therealmiguel/Diplomarbeit/README.md

# Diplomarbeit
AQS – Autonomous Quadcopter System: GPSunabhängige autonome Navigation eines Quadcopters mittels visueller Tiefenerkennung und Künstlicher Intelligenz
