therealmiguel/Diplomarbeit/3D/render.png

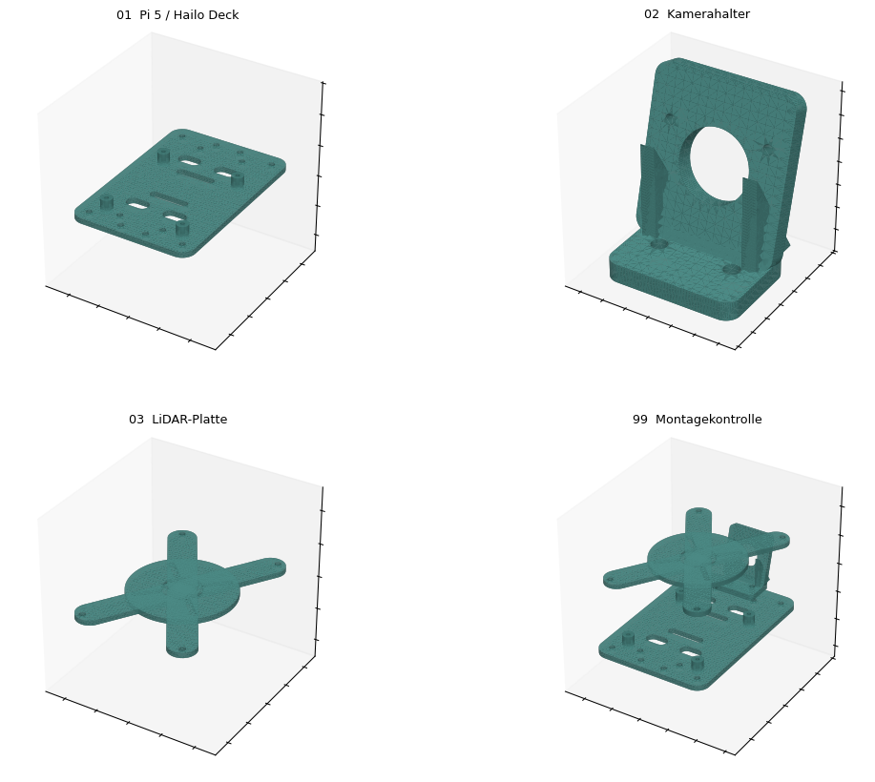
3D/render.png
