therealmiguel/Diplomarbeit/3D/99_assembly_check.stl

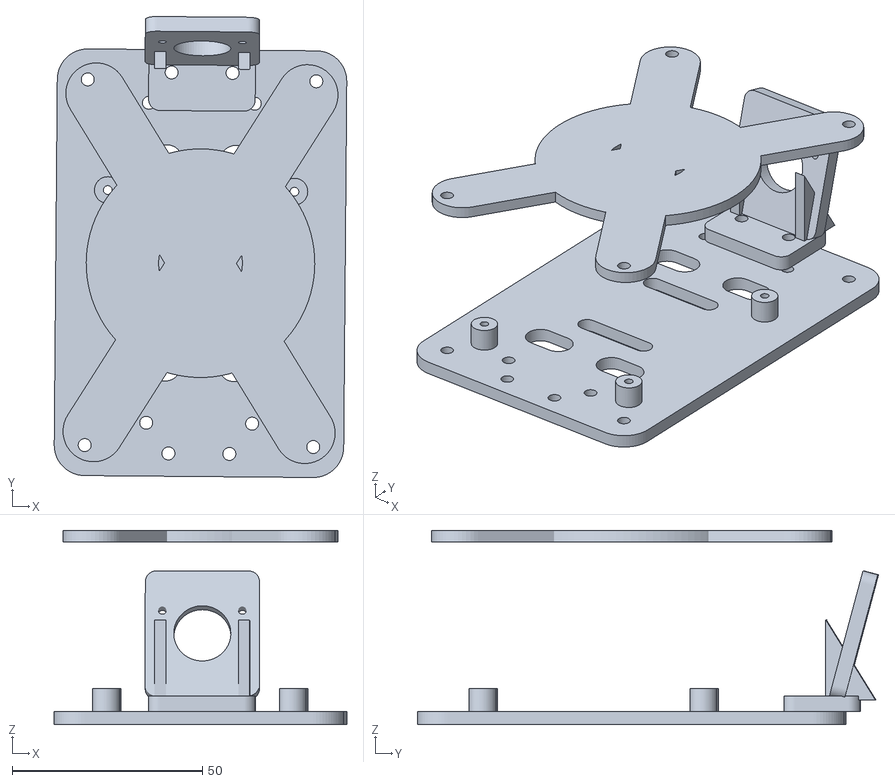
[picture p2: CAD file, 2026-10-07]
3D/99_assembly_check.stl
76.8 x 121.0 x 51.0
