therealmiguel/Diplomarbeit/3D/04_stuetzen_35mm.stl

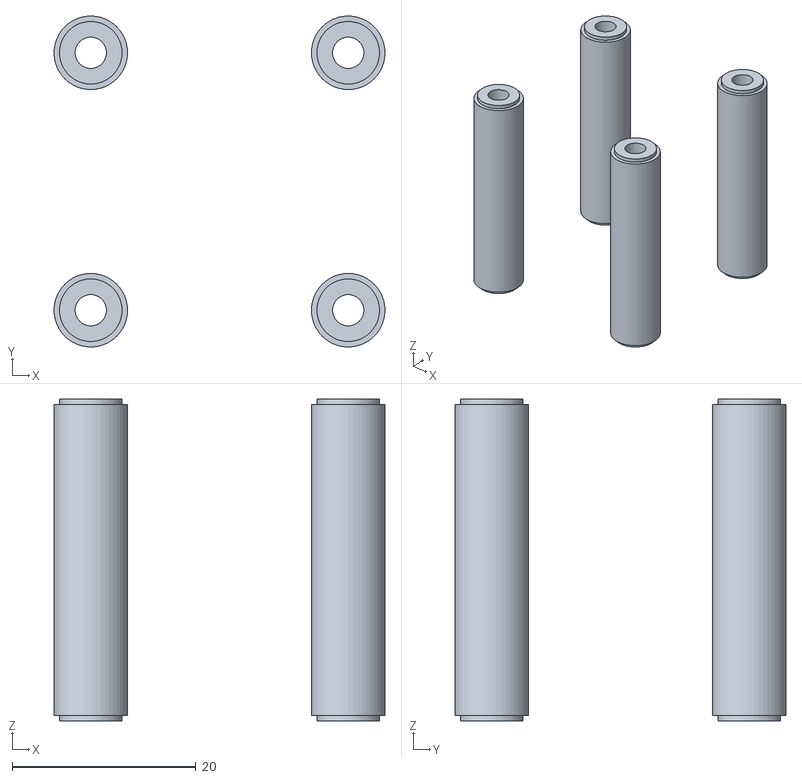
[picture p3: CAD file, 2026-10-07]
3D/04_stuetzen_35mm.stl
36.0 x 36.0 x 35.0
