therealmiguel/Diplomarbeit/3D/LX7+Drone+Frame_stls/obj_12_Standoff.step.stl

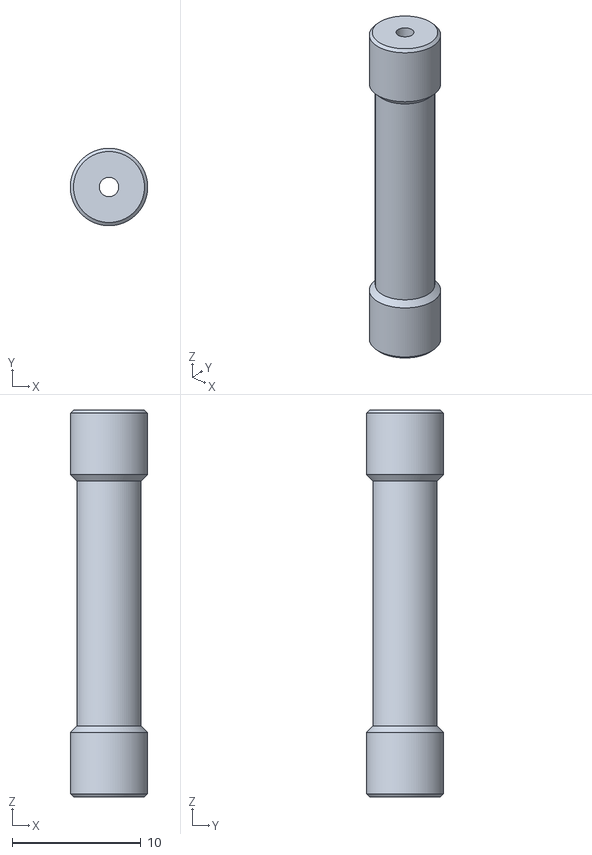
[picture p4: CAD file, 2026-10-07]
3D/LX7+Drone+Frame_stls/obj_12_Standoff.step.stl
6.00 x 6.00 x 30.0
