therealmiguel/Diplomarbeit/3D/03_lidar_plate.stl

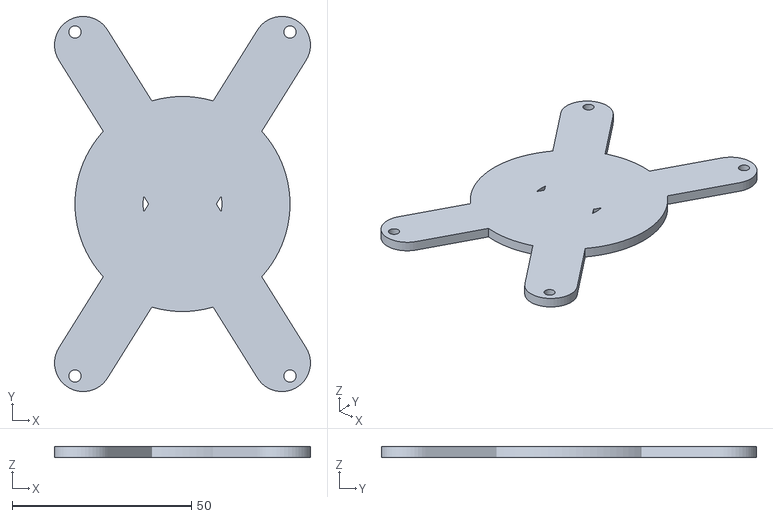
[picture p5: CAD file, 2026-10-07]
3D/03_lidar_plate.stl
71.4 x 104.7 x 3.00
