therealmiguel/Diplomarbeit/3D/LX7+Drone+Frame_stls/obj_17_Bottom Plate.step.stl

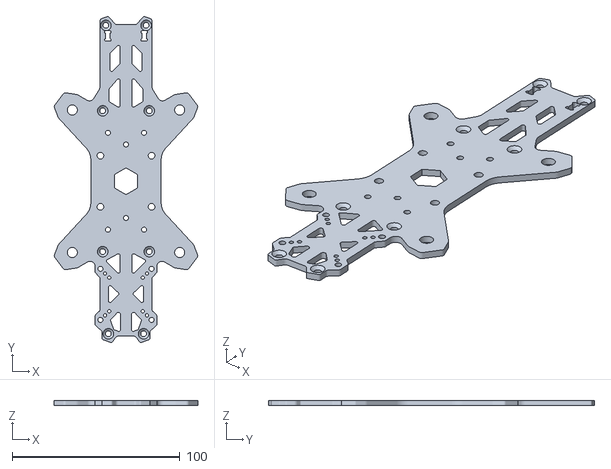
[picture p6: CAD file, 2026-10-07]
3D/LX7+Drone+Frame_stls/obj_17_Bottom Plate.step.stl
85.6 x 194.5 x 3.00
