therealmiguel/Diplomarbeit/3D/01_pi_deck.stl

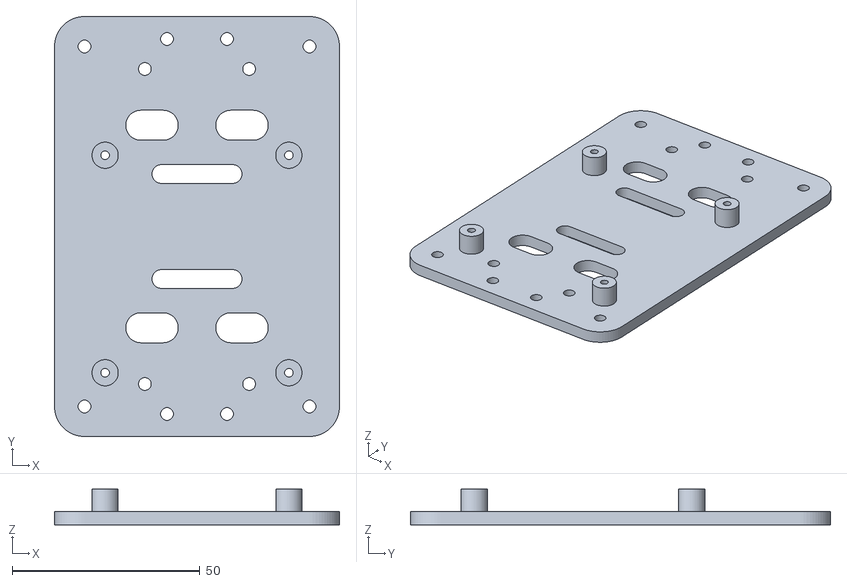
[picture p7: CAD file, 2026-10-07]
3D/01_pi_deck.stl
76.0 x 112.0 x 9.50
