therealmiguel/Diplomarbeit/3D/04_stuetzen_25mm.stl

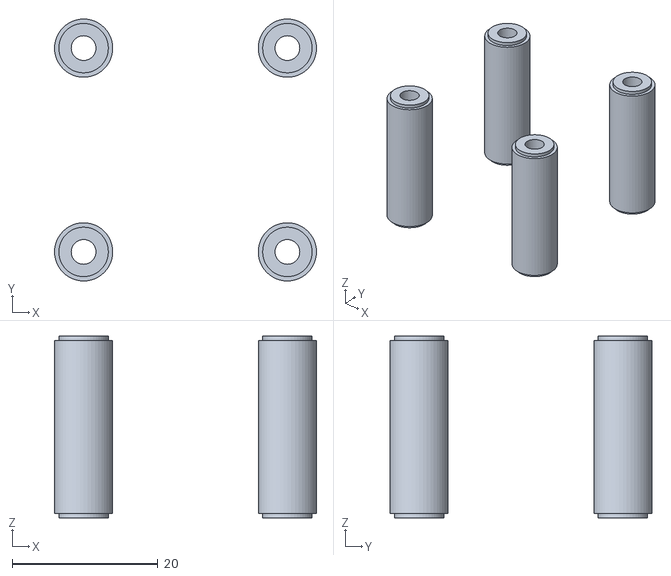
[picture p8: CAD file, 2026-10-07]
3D/04_stuetzen_25mm.stl
36.0 x 36.0 x 25.0
