therealmiguel/Diplomarbeit/3D/LX7+Drone+Frame_stls/obj_4_Arm.step.stl

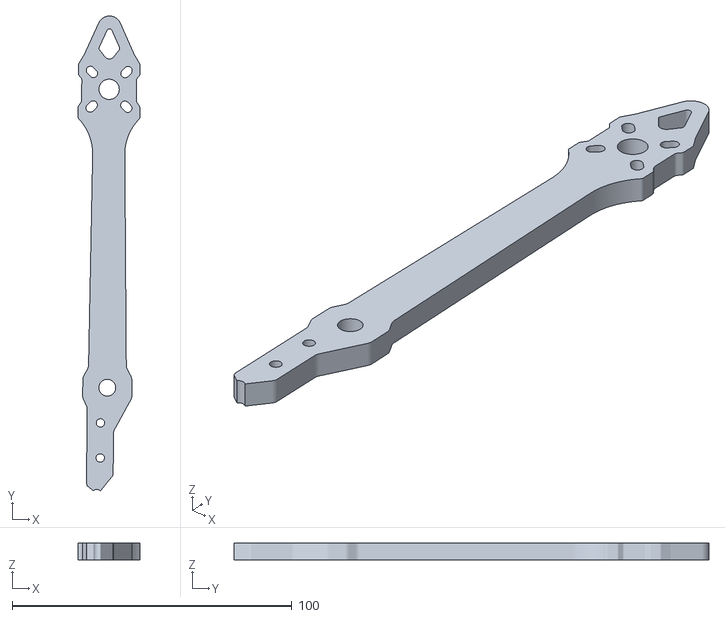
[picture p9: CAD file, 2026-10-07]
3D/LX7+Drone+Frame_stls/obj_4_Arm.step.stl
22.2 x 169.9 x 6.00
