therealmiguel/Diplomarbeit/3D/04_stuetzen_40mm.stl

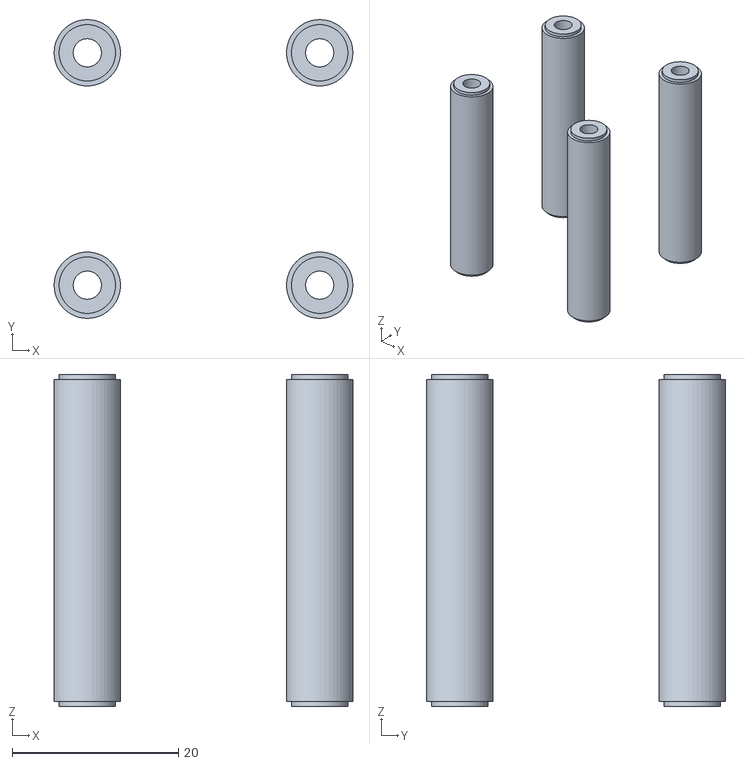
[picture p10: CAD file, 2026-10-07]
3D/04_stuetzen_40mm.stl
36.0 x 36.0 x 40.0
