therealmiguel/Diplomarbeit/3D/LX7+Drone+Frame_stls/obj_2_Arm Plate.step.stl

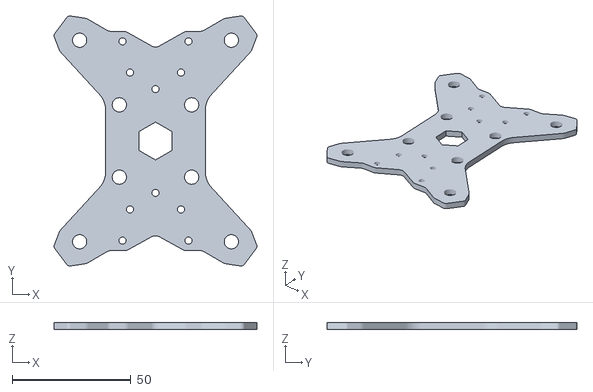
[picture p11: CAD file, 2026-10-07]
3D/LX7+Drone+Frame_stls/obj_2_Arm Plate.step.stl
85.6 x 105.5 x 3.00
