therealmiguel/Diplomarbeit/3D/04_stuetzen_30mm.stl

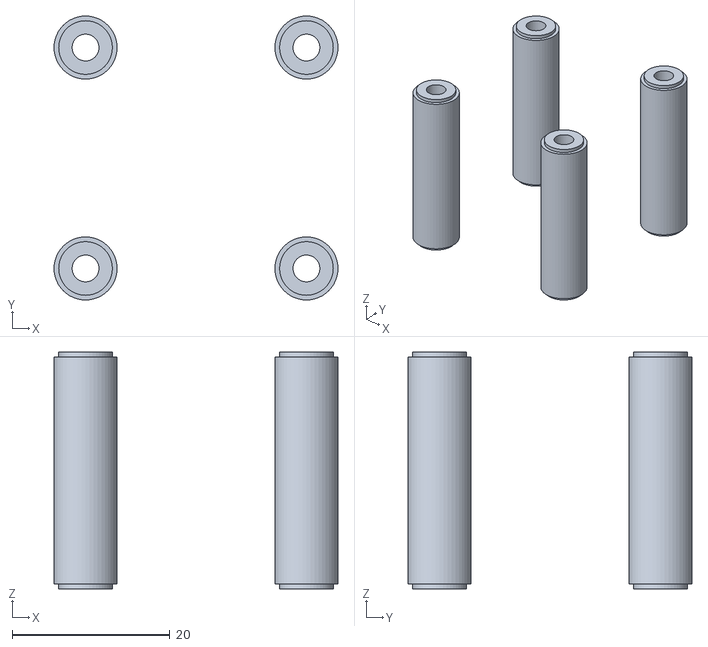
[picture p12: CAD file, 2026-10-07]
3D/04_stuetzen_30mm.stl
36.0 x 36.0 x 30.0
