therealmiguel/Diplomarbeit/3D/02_camera_mount.stl

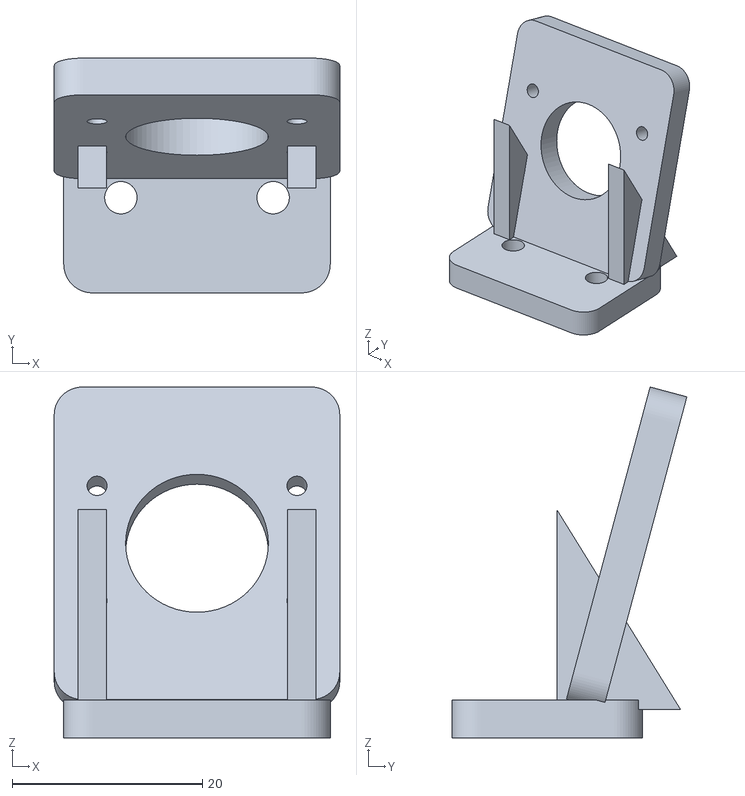
[picture p13: CAD file, 2026-10-07]
3D/02_camera_mount.stl
30.0 x 24.7 x 36.9
