therealmiguel/Diplomarbeit/3D/LX7+Drone+Frame_stls/obj_3_Top Plate.step.stl

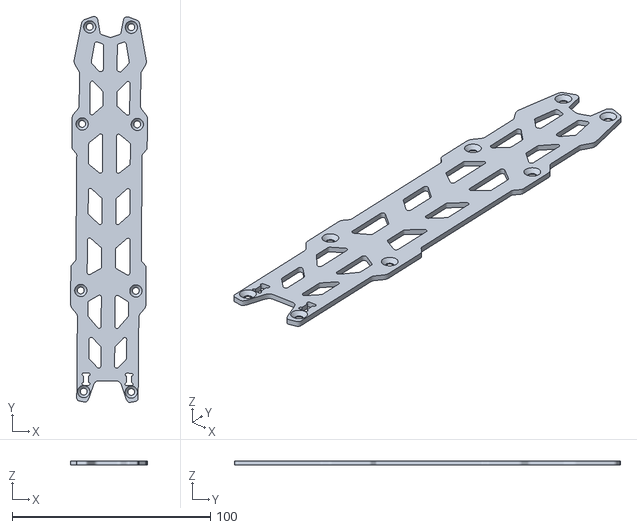
[picture p14: CAD file, 2026-10-07]
3D/LX7+Drone+Frame_stls/obj_3_Top Plate.step.stl
38.8 x 194.7 x 2.00
