therealmiguel/Diplomarbeit/3D/LX7+Drone+Frame_stls/obj_8_Armstop001.step.stl

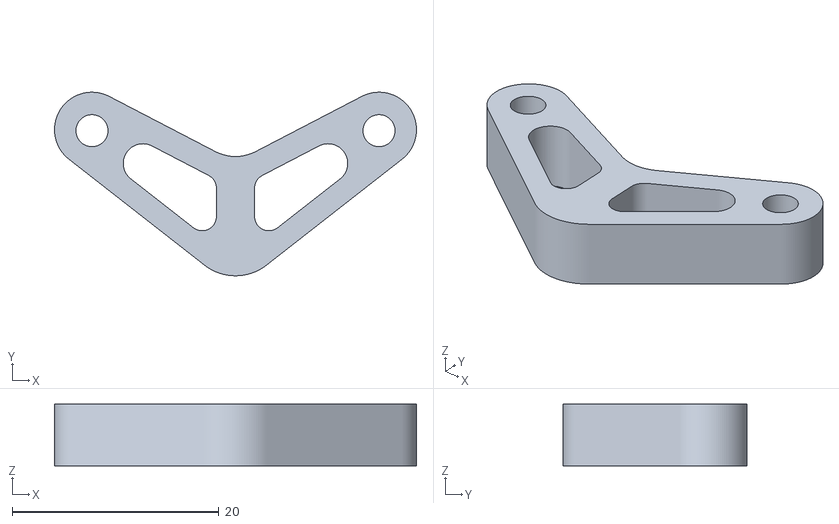
[picture p15: CAD file, 2026-10-07]
3D/LX7+Drone+Frame_stls/obj_8_Armstop001.step.stl
35.1 x 17.8 x 6.00
