therealmiguel/Diplomarbeit/(list of files, cad)

Other CAD files:
3D/LX7+Drone+Frame_stls/obj_16_Standoff.step.stl
3D/LX7+Drone+Frame_stls/obj_10_Standoff.step.stl
3D/LX7+Drone+Frame_stls/obj_7_Arm001.step.stl
3D/LX7+Drone+Frame_stls/obj_13_Standoff.step.stl
3D/LX7+Drone+Frame_stls/obj_11_Standoff.step.stl
3D/LX7+Drone+Frame_stls/obj_6_Arm002.step.stl
3D/LX7+Drone+Frame_stls/obj_5_Arm003.step.stl
3D/LX7+Drone+Frame_stls/obj_1_Standoff.step.stl
3D/LX7+Drone+Frame_stls/obj_15_Standoff.step.stl
3D/LX7+Drone+Frame_stls/obj_14_Standoff.step.stl
3D/LX7+Drone+Frame_stls/obj_9_Armstop.step.stl
