therealmiguel/Diplomarbeit/Raspberry Pi vulture – Setup-Dokumentation.docx

# Raspberry Pi vulture – Setup-Dokumentation

Nov 12, 2026 · @N D

## Überblick

Der Pi vulture steuert den Diplomarbeits-Quadcopter per MAVLink. Hailo-Erkennung, Simulator-Flug und Lidar-Auslesen funktionieren. Die echte Verbindung zum Flight Controller ist noch nicht getestet.

### Hardware

Teil | Modell | Anschluss am Pi
Rechner | Raspberry Pi 5, 8 GB, Hostname vulture | –
KI-Beschleuniger | Hailo AI HAT+ (Hailo-8L, 13 TOPS) | PCIe
Kamera | Raspberry Pi Camera Module 3 (imx708) | CSI-Flachbandkabel
Lidar | WitMotion D6 TOF (Sensor COIN-D6), 360°, 0,05–12 m | USB über CH341-Adapter, /dev/ttyUSB0, 230400 Baud
Flight Controller | SpeedyBee F405 V5 mit ArduCopter | UART (/dev/ttyAMA0, 921600 Baud), geplant
Empfänger | RadioMaster RP1 V2 (ELRS) | am FC, nicht am Pi
Optical Flow | Matek 3901-L0X | am FC, noch nicht angeschlossen
Akku | 4S LiPo 3300 mAh | über UBEC an die GPIO-Pins

### Die zwei Pis

Hostname | Pi | Strom | Zweck
vulture | Pi 5, 8 GB | Nur über GPIO-Pins (UBEC + Akku). Der USB-C-Eingang ist defekt. | Flug-Pi, später ROS2/SLAM
kit | Pi 5, 2 GB, eigener Hailo-HAT und Kamera | normal über USB-C | Altes Diplomarbeits-System (YOLOv8-Demo), jetzt Einrichtungs-Pi

### Ablauf mit der SD-Karte

1. Die SD-Karte von vulture steckt im 2-GB-Pi. Der startet dann als vulture mit allem, was installiert ist.
2. Dort richtest du alles ein, was wenig RAM braucht: Python-Code, Hailo-Tests, Lidar, pip-Pakete.
3. Danach die Karte zurück in den 8-GB-Pi.
4. Auf dem 8-GB-Pi: ROS2, SLAM, Docker-Builds und PSU_MAX_CURRENT (steht im EEPROM des Boards, nicht auf der Karte).

Bricht etwas auf dem 2-GB-Pi mit „Killed“ ab, war fast immer der RAM zu knapp. Das gehört dann auf den 8-GB-Pi.

### Sicherheitsregeln

- Nie UBEC und USB-C gleichzeitig anstecken.
- UBEC über einen Stecker anschließen, nicht direkt anlöten, und alles mit Schrumpfschlauch isolieren.
- Propeller ab, solange der Pi am FC hängt oder getestet wird.
- Nur einen Pi gleichzeitig einschalten, sonst kommen sich die Namen in die Quere.

## Verbinden vom Laptop (Windows-Eingabeaufforderung)

Alles läuft per SSH aus der Windows-CMD. Laptop und Pi müssen im selben WLAN sein.

### 1. Per SSH einloggen

Pi einschalten, 30–60 Sekunden warten, dann in der CMD:

ssh vulture@vulture.local

Klappt das nicht, ist vielleicht der andere Pi an:

ssh kit@kit.local

Wird .local nicht aufgelöst, die IP im Router unter „Angeschlossene Geräte“ nachsehen und ssh vulture@<IP> nehmen.

### 2. Prüfen, welcher Pi es ist

hostname
free -h | head -2
ls ~
hostname -I

Ausgabe | Bedeutung
vulture, ca. 8 GB, Ordner hailo-apps und vulture-flight | 8-GB-Pi mit der Flug-Karte
vulture, ca. 2 GB | Flug-Karte im 2-GB-Pi
kit | alte Karte, alter Pi

hostname -I zeigt die IP. Die brauchst du für den Simulator (zuletzt war es 192.168.1.37).

### 3. Desktop per VNC

Einmalig am Pi einschalten:

sudo raspi-config

→ 3 Interface Options → VNC → Yes → Finish. Dabei wird der Dienst wayvnc angelegt.

Am Laptop TigerVNC Viewer öffnen, Adresse vulture.local:5900, Benutzer vulture und dein Pi-Passwort. Die Zertifikatswarnung kannst du bestätigen.

Verbindet es nicht:

systemctl status wayvnc --no-pager | head -5
sudo systemctl restart wayvnc

### 4. Code auf den Laptop sichern

In einer eigenen CMD am Laptop (nicht im SSH-Fenster):

scp -r vulture@vulture.local:~/vulture-flight .

Das kopiert den ganzen Ordner vulture-flight in den aktuellen Ordner der CMD.

### 5. Alles sauber abdrehen

1. Laufende Programme mit Strg+C beenden, VNC-Fenster schließen.
2. Pi herunterfahren:

sudo shutdown now

3. Warten, bis die grüne LED nicht mehr blinkt (10–20 Sekunden). Erst dann den Strom abstecken.
4. Lidar-USB-Adapter abziehen, Akku abstecken. In Mission Planner Disconnect, dann USB vom FC.
5. Akku auf eine nicht brennbare Unterlage oder in die LiPo-Tasche. Fliegst du ein paar Tage nicht, mit Storage am iMars auf ca. 3,8 V pro Zelle laden.

## Grundsystem und Hailo

Die Hailo-Seite ist fertig: Treiber, Modelle für hailo8l und die Live-Erkennung mit der Kamera laufen.

### Was installiert ist (Stand 26./27. August)

Komponente | Stand
Betriebssystem | Raspberry Pi OS 64-bit, headless mit SSH, Kernel 6.18
PCIe | Gen3 aktiv: dtparam=pciex1_gen=3 in /boot/firmware/config.txt
Hailo-Pakete | hailo-all 5.1.1 per apt (Treiber, Firmware, HailoRT, TAPPAS 5.1.0, rpicam-Hailo-Postprocess)
hailo-rpi5-examples | ließ sich nicht kompilieren, gelöscht
~/hailo-apps | installiert, venv venv_hailo_apps, 20 Modelle (.hef) unter /usr/local/hailo/resources, 15 C++-Postprocess-Libs
Werkzeuge | tmux
Python-Pakete | pymavlink 2.4.50, pyserial

### Hailo-Umgebung aktivieren

cd ~/hailo-apps && source setup_env.sh

Danach steht (venv_hailo_apps) vor dem Prompt.

### Zustand prüfen

hostname
free -h | head -2
hailortcli fw-control identify
rpicam-hello --list-cameras
vcgencmd get_throttled
grep -E "pciex1|uart|usb_max" /boot/firmware/config.txt
ls ~

Befehl | Erwartet
hailortcli fw-control identify | Device Architecture: HAILO8L („Board Name: Hailo-8“ ist normal)
rpicam-hello --list-cameras | 0 : imx708 [4608x2592 10-bit RGGB]
vcgencmd get_throttled | throttled=0x0 = keine Unterspannung

### Architektur der Modelle prüfen

Der Installer meldete damals „hailo8“. Geprüft ist: Die Konfiguration stimmt.

cat /usr/local/hailo/resources/.env
ls /usr/local/hailo/resources/models/

In der .env muss hailo_arch=hailo8l stehen. Bei dir steht außerdem: hailort_version=4.23.0, tappas_version=5.1.0, model_zoo_version=v2.17.0.

### Live-Erkennung mit Kamera und Hailo

Im Terminal auf dem VNC-Desktop (nicht per SSH, weil ein Fenster aufgeht):

rpicam-hello -t 0 --post-process-file /usr/share/rpi-camera-assets/hailo_yolov8_inference.json --lores-width 640 --lores-height 640

Es öffnet sich das Kamerabild mit Rahmen um erkannte Objekte. Beenden mit Strg+C. Das hat funktioniert.

### Hailo-Apps für vision.py ansehen

cd ~/hailo-apps && source setup_env.sh
ls hailo_apps/hailo_app_python/apps/
ls hailo_apps/hailo_app_python/apps/detection
grep -n "callback\|get_roi_from_buffer\|get_objects_typed\|get_label\|get_bbox" -r hailo_apps/hailo_app_python/apps/detection | head -30

Die Ausgabe davon fehlt noch. Erst damit lässt sich vision.py passend zur Repo-Version schreiben.

## UART und MAVLink zum SpeedyBee F405

Am Pi ist der UART freigeschaltet, und der FC armt per Fernsteuerung. Das Kabel Pi ↔ FC und der Test am echten FC fehlen noch.

### 1. UART am Pi aktivieren (erledigt)

sudo raspi-config

→ 3 Interface Options → Serial Port:

- „Login shell over serial?“ → No
- „Serial port hardware enabled?“ → Yes

Dann:

echo "dtparam=uart0=on" | sudo tee -a /boot/firmware/config.txt
mkdir -p ~/vulture-flight
source ~/hailo-apps/setup_env.sh
pip install pymavlink pyserial
sudo reboot

Nach dem Neustart prüfen:

ls -l /dev/ttyAMA0
grep -E "enable_uart|uart0" /boot/firmware/config.txt

In deiner config.txt steht dtparam=uart0=on zweimal. Das schadet nicht, eine Zeile kannst du mit sudo nano /boot/firmware/config.txt löschen.

### 2. Verkabelung Pi ↔ FC (noch offen)

TX und RX werden gekreuzt, 5 V wird nicht verbunden. Beide Seiten arbeiten mit 3,3 V.

Pi 5 | SpeedyBee F405 V5 (UART4)
Pin 8 (GPIO14, TX) | RX4
Pin 10 (GPIO15, RX) | TX4
Pin 6 (GND) | GND

### 3. ArduPilot-Parameter

In Mission Planner unter Config → Full Parameter List, schreiben und FC neu starten.

Parameter | Wert | Bedeutung | Stand
SERIAL2_PROTOCOL | 23 | RC-Eingang für den RP1 auf UART2 | gesetzt
SERIAL6_PROTOCOL | -1 | UART6 aus | gesetzt
MOT_PWM_TYPE | 6 | DShot600. Bei 0 haben die Motoren nicht reagiert. | gesetzt
COMPASS_ENABLE | 0 | Kein Kompass auf dem Board, GPS geht indoor nicht | gesetzt
SERIAL4_PROTOCOL | 2 | MAVLink2 zum Pi auf UART4 | geplant
SERIAL4_BAUD | 921 | 921600 Baud | geplant

Die Motoren armen und reagieren mit der RadioMaster im Mode 2: links Gas und Gier, rechts Nick und Roll.

### 4. Auf echten FC umstellen

In ~/vulture-flight/config.py SIM = False setzen:

sed -i 's/^SIM = .*/SIM = False/' ~/vulture-flight/config.py

Dann verbindet link.py über /dev/ttyAMA0 mit 921600 Baud statt mit dem Simulator. Erst mit Propellern ab testen.

## Flugcode im Simulator

Der Pi hat den virtuellen Copter in Mission Planner gestartet, bewegt (GroundSpeed über 1 m/s) und gelandet. Alle Dateien liegen in ~/vulture-flight.

### Simulator am Laptop starten

1. Mission Planner → oben Simulation → Multirotor → Stable, warten, bis der Copter auf der Karte steht.
2. Strg+F → MAVLink → UDP Client, IP = IP des Pi (hostname -I, zuletzt 192.168.1.37), Port 14550.
3. Erst dann die Skripte am Pi starten.

### Dateien im Ordner

Datei | Zweck
test_sim.py | erster Verbindungstest, liest 5-mal die Höhe
test_flug.py | GUIDED, armen, 2 m hoch, 5 s vorwärts, landen
config.py | Umschalter Simulator / echter FC
link.py | wiederverwendbares Modul für MAVLink
test_quadrat.py | fliegt mit link.py ein Quadrat
lidar_decode.py, lidar.py, test_lidar.py | Lidar, siehe nächster Abschnitt

Jeden Block komplett ins SSH-Fenster kopieren. Der cat > ... << 'EOF'-Befehl legt die Datei an, bis zur Zeile EOF.

### test_sim.py

cat > ~/vulture-flight/test_sim.py << 'EOF'
from pymavlink import mavutil

print("Warte auf den Simulator...")
m = mavutil.mavlink_connection('udpin:0.0.0.0:14550')
m.wait_heartbeat(timeout=30)
print(f"Verbunden mit System {m.target_system}")

for _ in range(5):
msg = m.recv_match(type='GLOBAL_POSITION_INT', blocking=True, timeout=5)
if msg:
print(f"Höhe: {msg.relative_alt/1000:.2f} m")
EOF

Starten: python ~/vulture-flight/test_sim.py. Ergebnis bei dir: Verbunden mit System 1, danach fünfmal Höhe: -0.01 m.

### test_flug.py

cat > ~/vulture-flight/test_flug.py << 'EOF'
import time
from pymavlink import mavutil

m = mavutil.mavlink_connection('udpin:0.0.0.0:14550')

# Auf den Copter warten (nicht auf Mission Planner selbst)
while True:
hb = m.recv_match(type='HEARTBEAT', blocking=True)
if hb.type != mavutil.mavlink.MAV_TYPE_GCS:
m.target_system = hb.get_srcSystem()
m.target_component = hb.get_srcComponent()
break
print("Verbunden mit dem Copter")

def hoehe():
msg = m.recv_match(type='GLOBAL_POSITION_INT', blocking=True, timeout=3)
return msg.relative_alt / 1000 if msg else 0.0

def fliege(vx, vy, dauer):
# vx = vorwärts, vy = rechts, in m/s
ende = time.time() + dauer
while time.time() < ende:
m.mav.set_position_target_local_ned_send(
0, m.target_system, m.target_component,
mavutil.mavlink.MAV_FRAME_BODY_OFFSET_NED,
0b0000111111000111,
0, 0, 0, vx, vy, 0, 0, 0, 0, 0, 0)
time.sleep(0.1)

# 1. GUIDED-Modus und Motoren an
m.set_mode('GUIDED')
time.sleep(1)
m.arducopter_arm()
m.motors_armed_wait()
print("Motoren an")

# 2. Abheben auf 2 m
m.mav.command_long_send(m.target_system, m.target_component,
mavutil.mavlink.MAV_CMD_NAV_TAKEOFF, 0, 0, 0, 0, 0, 0, 0, 2)
while True:
h = hoehe()
print(f"Höhe: {h:.2f} m")
if h > 1.9:
break

# 3. Vorwärts, dann stehen bleiben
print("Fliege vorwärts")
fliege(1.0, 0, 5)
print("Halte Position")
fliege(0, 0, 3)

# 4. Landen
print("Lande")
m.set_mode('LAND')
m.motors_disarmed_wait()
print("Gelandet, Motoren aus")
EOF

Starten: python ~/vulture-flight/test_flug.py.

### config.py

cat > ~/vulture-flight/config.py << 'EOF'
# True = Simulator am Laptop, False = echter F405 per UART
SIM = True

VERBINDUNG_SIM = 'udpin:0.0.0.0:14550'
VERBINDUNG_FC = '/dev/ttyAMA0'
BAUD_FC = 921600
EOF

### link.py

Läuft im Hintergrund mit und kennt immer Höhe, Lage, Modus und ob die Motoren an sind.

cat > ~/vulture-flight/link.py << 'EOF'
import time
import threading
from pymavlink import mavutil
import config

GCS = mavutil.mavlink.MAV_TYPE_GCS


class Link:
def __init__(self):
if config.SIM:
self.m = mavutil.mavlink_connection(config.VERBINDUNG_SIM)
else:
self.m = mavutil.mavlink_connection(config.VERBINDUNG_FC, baud=config.BAUD_FC)

# aktueller Zustand, wird im Hintergrund laufend aktualisiert
self.hoehe = 0.0
self.modus = ''
self.armed = False
self.roll = self.pitch = self.yaw = 0.0

self._warte_auf_copter()
self._laeuft = True
threading.Thread(target=self._empfangen, daemon=True).start()
time.sleep(1)

def _warte_auf_copter(self):
print('Warte auf Copter...')
while True:
hb = self.m.recv_match(type='HEARTBEAT', blocking=True)
if hb.type != GCS:
self.m.target_system = hb.get_srcSystem()
self.m.target_component = hb.get_srcComponent()
print(f'Verbunden mit System {self.m.target_system}')
return

def _empfangen(self):
while self._laeuft:
msg = self.m.recv_match(blocking=True, timeout=1)
if msg is None:
continue
typ = msg.get_type()
if typ == 'GLOBAL_POSITION_INT':
self.hoehe = msg.relative_alt / 1000
elif typ == 'ATTITUDE':
self.roll, self.pitch, self.yaw = msg.roll, msg.pitch, msg.yaw
elif typ == 'HEARTBEAT' and msg.type != GCS \
and msg.get_srcSystem() == self.m.target_system:
self.modus = mavutil.mode_string_v10(msg)
self.armed = bool(msg.base_mode & mavutil.mavlink.MAV_MODE_FLAG_SAFETY_ARMED)

def _warte_bis(self, bedingung, timeout):
ende = time.time() + timeout
while time.time() < ende:
if bedingung():
return True
time.sleep(0.1)
return False

def modus_setzen(self, name):
self.m.set_mode(name)
if self._warte_bis(lambda: self.modus == name, 5):
print(f'Modus: {name}')
return True
print(f'FEHLER: Moduswechsel auf {name} fehlgeschlagen')
return False

def armen(self):
self.m.arducopter_arm()
if self._warte_bis(lambda: self.armed, 10):
print('Motoren an')
return True
print('FEHLER: Armen fehlgeschlagen (Pre-Arm-Checks in Mission Planner ansehen)')
return False

def abheben(self, ziel_hoehe):
self.m.mav.command_long_send(
self.m.target_system, self.m.target_component,
mavutil.mavlink.MAV_CMD_NAV_TAKEOFF, 0, 0, 0, 0, 0, 0, 0, ziel_hoehe)
ende = time.time() + 20
while time.time() < ende:
print(f'Höhe: {self.hoehe:.2f} m')
if self.hoehe >= ziel_hoehe * 0.95:
print('Zielhöhe erreicht')
return True
time.sleep(0.5)
print('FEHLER: Zielhöhe nicht erreicht')
return False

def geschwindigkeit(self, vx, vy, vz=0.0, gier_rate=0.0):
"""Ein einzelner Befehl. vx vorwärts, vy rechts, vz positiv = sinken (m/s),
gier_rate in rad/s. Muss laufend wiederholt werden, sonst stoppt ArduPilot."""
self.m.mav.set_position_target_local_ned_send(
0, self.m.target_system, self.m.target_component,
mavutil.mavlink.MAV_FRAME_BODY_OFFSET_NED,
0b0000010111000111,
0, 0, 0, vx, vy, vz, 0, 0, 0, 0, gier_rate)

def fliege(self, vx, vy, dauer, vz=0.0, gier_rate=0.0):
ende = time.time() + dauer
while time.time() < ende:
self.geschwindigkeit(vx, vy, vz, gier_rate)
time.sleep(0.1)

def halten(self, dauer):
self.fliege(0, 0, dauer)

def landen(self):
print('Lande...')
self.modus_setzen('LAND')
if self._warte_bis(lambda: not self.armed, 60):
print('Gelandet, Motoren aus')
return True
print('WARNUNG: Motoren nach 60 s noch an')
return False

def schliessen(self):
self._laeuft = False
EOF

Funktion | Was sie tut
modus_setzen('GUIDED') | wechselt den Flugmodus und wartet bis zu 5 s auf die Bestätigung
armen() | Motoren an, wartet bis zu 10 s
abheben(2.0) | steigt auf die Zielhöhe in m
fliege(vx, vy, dauer) | Geschwindigkeit in m/s: vx vorwärts, vy rechts, für dauer Sekunden
halten(dauer) | Position halten
landen() | LAND-Modus, wartet bis die Motoren aus sind
hoehe, modus, armed, roll, pitch, yaw | aktueller Zustand

### test_quadrat.py

cat > ~/vulture-flight/test_quadrat.py << 'EOF'
from link import Link

copter = Link()

try:
if not copter.modus_setzen('GUIDED'):
raise SystemExit
if not copter.armen():
raise SystemExit
copter.abheben(2.0)

print('Quadrat: vor, rechts, zurück, links')
copter.fliege(1.0, 0, 3)
copter.fliege(0, 1.0, 3)
copter.fliege(-1.0, 0, 3)
copter.fliege(0, -1.0, 3)
copter.halten(2)
finally:
# passiert immer, auch bei Fehlern oder Strg+C
if copter.armed:
copter.landen()
copter.schliessen()
EOF

Starten, und zwar aus dem Ordner heraus, damit Python link.py findet:

cd ~/vulture-flight
python test_quadrat.py

Der Copter fliegt ein Quadrat mit etwa 3 m Seitenlänge und landet. Der finally-Block sorgt dafür, dass er auch bei Fehlern oder Strg+C landet.

## Lidar WitMotion D6 TOF

Das Lidar liefert verlässliche Abstände rundum. Geprüft ist das mit dem iPad in ca. 20 cm Abstand (gemessen 181–231 mm). Nur die Richtung „vorne“ (OFFSET) ist noch nicht eingestellt.

### Eckdaten

Wert | Angabe
Scan | 360°, 10 Umdrehungen/s, ca. 4000 Punkte/s, Winkelabstand 0,9°
Reichweite | 0,05–12 m, Genauigkeit ±10 mm bis 1 m, ±40 mm darüber
Anschluss | UART 230400 Baud über CH341-USB-Adapter, /dev/ttyUSB0
Versorgung | 4,5–5,5 V
Maße, Gewicht | 52,7 × 45,2 × 34,4 mm, 40 g

### Protokoll (aus den Rohdaten ermittelt, keine offizielle Doku)

Teil | Aufbau
Kennung | 0xAA 0x55 am Anfang jedes Pakets
Paketlänge | 85 Byte = 10 Byte Kopf + 25 Punkte à 3 Byte
Startwinkel | Bytes 4 und 5: ((b5 << 8 | b4) >> 1) / 64 in Grad
Punkt | 1 Byte Stärke, dann 2 Byte Rohwert (Little Endian)
Abstand | Rohwert >> 2 = Millimeter
Ablauf | Startwinkel steigt pro Paket um ca. 22,3°, 16 Pakete = eine Umdrehung

Die Prüfsumme wird noch nicht geprüft, weil ihr Algorithmus unbekannt ist.

### 1. Lidar finden

USB-Adapter einstecken, dann:

ls /dev/ttyUSB* /dev/ttyACM*
dmesg | tail -20

Es muss /dev/ttyUSB0 erscheinen.

### 2. lidar_decode.py (Protokoll-Test)

cat > ~/vulture-flight/lidar_decode.py << 'EOF'
import serial, time, statistics as st

s = serial.Serial('/dev/ttyUSB0', 230400, timeout=1)
time.sleep(1)
s.reset_input_buffer()
d = s.read(6000)

pakete = []
i = 0
while i < len(d) - 87:
if d[i:i+2] == b'\xaa\x55' and d[i+85:i+87] == b'\xaa\x55':
pakete.append(d[i:i+85])
i += 85
else:
i += 1
print(len(pakete), "Pakete")

print("Startwinkel Staerke Roh Roh/4")
for p in pakete[:20]:
winkel = ((p[5] << 8 | p[4]) >> 1) / 64
punkte = [p[10+3*k:13+3*k] for k in range(25)]
roh = int(st.median((q[2] << 8) | q[1] for q in punkte))
staerke = int(st.median(q[0] for q in punkte))
print(f"{winkel:10.1f} {staerke:7d} {roh:5d} {roh/4:6.1f}")
EOF
python3 ~/vulture-flight/lidar_decode.py

Ergebnis bei dir: 69 Pakete, Startwinkel 249,0 → 271,2 → 293,4 …, iPad bei Roh/4 = 181–231 mm.

### 3. lidar.py (Modul)

Liest im Hintergrund und speichert pro Grad den letzten Abstand.

cat > ~/vulture-flight/lidar.py << 'EOF'
import threading
import time
import serial

PORT = '/dev/ttyUSB0'
BAUD = 230400
OFFSET = 0.0 # Grad: so einstellen, dass 0 Grad = vorne
MIN_MM = 50
MAX_MM = 12000
PAKET = 85 # 10 Byte Kopf + 25 Punkte zu je 3 Byte
KOPF = b'\xaa\x55'


class Lidar:
def __init__(self, port=PORT, baud=BAUD, offset=OFFSET):
self.ser = serial.Serial(port, baud, timeout=0.2)
self.offset = offset
self.karte = [0] * 360 # mm pro Grad, 0 = keine Messung
self.zeit = [0.0] * 360
self.letztes_paket = 0.0
self.anzahl = 0
self._vorher = None
self._laeuft = True
threading.Thread(target=self._lesen, daemon=True).start()

def _lesen(self):
puffer = bytearray()
while self._laeuft:
puffer += self.ser.read(512)
while len(puffer) >= PAKET + 2:
if puffer[0:2] == KOPF and puffer[PAKET:PAKET + 2] == KOPF:
self._paket(bytes(puffer[:PAKET]))
del puffer[:PAKET]
else:
del puffer[0]

def _paket(self, p):
jetzt = time.time()
self.letztes_paket = jetzt
self.anzahl += 1
start = ((p[5] << 8 | p[4]) >> 1) / 64
if self._vorher is not None:
alt, alt_start = self._vorher
schritt = ((start - alt_start) % 360) / 25
if 0.5 < schritt < 1.3: # normal ca. 0.9 Grad, sonst Paket verloren
for k in range(25):
roh = (alt[12 + 3 * k] << 8) | alt[11 + 3 * k]
mm = roh >> 2
g = int(round(alt_start + k * schritt + self.offset)) % 360
self.karte[g] = mm if MIN_MM <= mm <= MAX_MM else 0
self.zeit[g] = jetzt
self._vorher = (p, start)

def abstand(self, von, bis, max_alter=0.5):
"""Kleinster Abstand in mm im Sektor von..bis (Grad). None = nichts gemessen."""
jetzt = time.time()
if von <= bis:
grad = range(int(von), int(bis) + 1)
else:
grad = list(range(int(von), 360)) + list(range(0, int(bis) + 1))
werte = [self.karte[g % 360] for g in grad
if self.karte[g % 360] > 0 and jetzt - self.zeit[g % 360] < max_alter]
return min(werte) if werte else None

def sektor(self, mitte, breite=30):
return self.abstand((mitte - breite) % 360, (mitte + breite) % 360)

def vorne(self):
return self.sektor(0)

def rechts(self):
return self.sektor(90)

def hinten(self):
return self.sektor(180)

def links(self):
return self.sektor(270)

def naechstes(self):
jetzt = time.time()
beste = None
for g in range(360):
if self.karte[g] > 0 and jetzt - self.zeit[g] < 0.5:
if beste is None or self.karte[g] < beste[1]:
beste = (g, self.karte[g])
return beste

def ok(self):
"""False, wenn das Lidar keine Daten mehr schickt."""
return time.time() - self.letztes_paket < 0.5

def schliessen(self):
self._laeuft = False
EOF

Funktion | Rückgabe
vorne(), rechts(), hinten(), links() | kleinster Abstand in mm im Sektor ±30°, oder None
abstand(von, bis) | kleinster Abstand in mm zwischen zwei Winkeln
naechstes() | (Winkel, mm) des nächsten Objekts
ok() | False, wenn seit 0,5 s keine Daten kamen. Daran hängt später der Notstopp.

None bzw. -- heißt „nichts gemessen“, nicht „frei“. Glas, Spiegel und sehr dunkle Flächen gibt das Lidar oft nicht zurück.

### 4. test_lidar.py (Livetest)

cat > ~/vulture-flight/test_lidar.py << 'EOF'
import time
from lidar import Lidar


def cm(x):
return ' -- ' if x is None else f'{x / 10:6.1f}'


l = Lidar()
time.sleep(1.5)
try:
while True:
print(f'ok={l.ok()} vorne {cm(l.vorne())} rechts {cm(l.rechts())} '
f'hinten {cm(l.hinten())} links {cm(l.links())} cm naechstes: {l.naechstes()}')
time.sleep(0.5)
except KeyboardInterrupt:
l.schliessen()
EOF

Starten, und zwar aus dem Ordner heraus:

cd ~/vulture-flight
python3 test_lidar.py

Alle 0,5 s erscheinen die Abstände in cm. Beenden mit Strg+C.

### 5. Richtung vorne einstellen (sobald das Lidar am Copter sitzt)

1. iPad ca. 30 cm vor die Seite halten, die nach vorne zeigt (dorthin, wo die Kamera schaut).
2. Bei naechstes: den Winkel ablesen, z. B. (330, 300) = 330°, 300 mm.
3. OFFSET = 360 − Winkel setzen, im Beispiel 30:

sed -i 's/^OFFSET = .*/OFFSET = 30.0/' ~/vulture-flight/lidar.py

4. Neu testen: iPad vorne muss bei vorne erscheinen, rechts bei rechts. Sind rechts und links vertauscht, muss die Zählrichtung umgedreht werden.

Beim Einbau: freie Sicht rundum, keine Streben, Props oder Kabel in der Scan-Ebene. Die Kabelseite am besten nach hinten.

## Architektur und Entscheidungen

Die Sensoren liefern dem Pi Daten, main.py entscheidet, und link.py schickt die Befehle an ArduPilot. Optical Flow und Empfänger hängen direkt am FC.

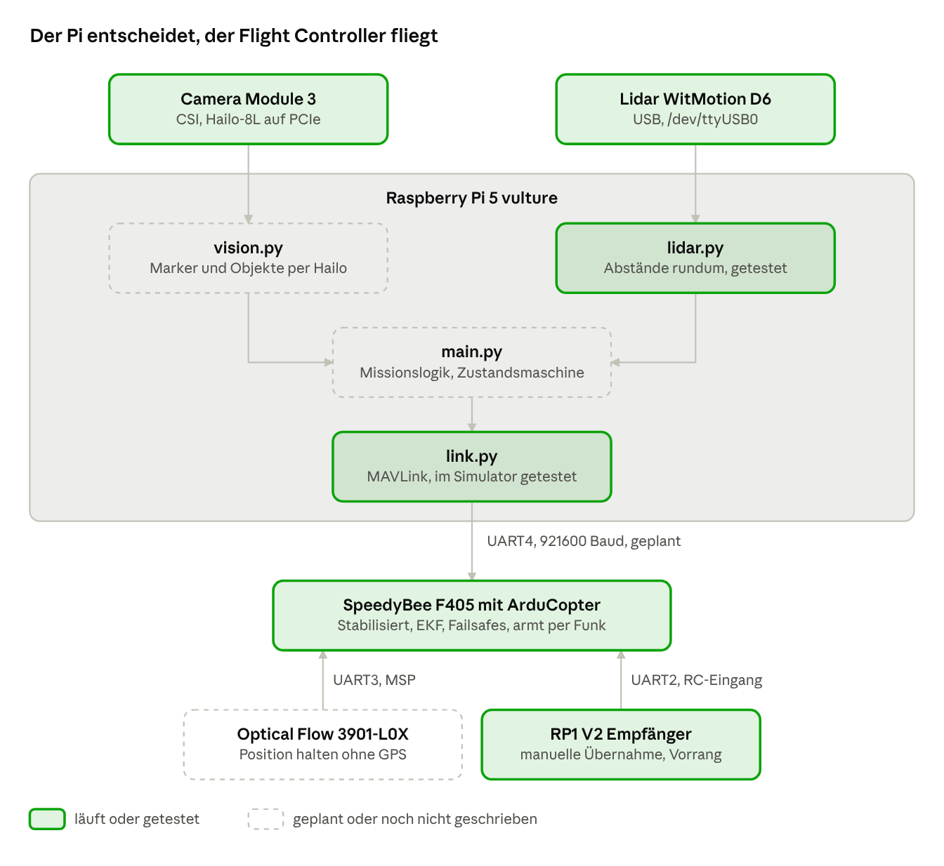
[picture p16: figure]
Systemaufbau · Sensoren, Pi-Module, Flight Controller

Systemaufbau · Sensoren, Pi-Module, Flight Controller

Grün ist, was schon läuft. vision.py und main.py fehlen noch, die Leitung Pi ↔ FC auch. Die Fernsteuerung hat immer Vorrang.

### Entscheidungen

Thema | Entscheidung
Hindernisse | Nur das Lidar. Es misst direkt in Millimetern und braucht kaum Rechenleistung.
Kamera | Nur gezielt bei Aufgaben, die das Lidar nicht kann: Landemarker (ArUco/AprilTag) finden, ein Objekt oder eine Person suchen
Steuerung | pymavlink im GUIDED-Modus mit Geschwindigkeitsbefehlen, kein DroneKit
ROS2 | Erst für Lidar-SLAM (slam_toolbox) und Nav2, in Docker, nur auf dem 8-GB-Pi
Optical Flow | Direkt am FC über MSP, hält die Position ohne GPS
Navigation (Konzept, November) | Teach & Repeat: Route einmal per Fernsteuerung fliegen, Hailo findet markante Punkte, die Drohne fliegt sie danach selbst ab. Dazwischen IMU, Optical Flow und Keypoints.

### UART-Belegung am F405

UART | Gerät | Parameter | Stand
UART2 | RP1-Empfänger | SERIAL2_PROTOCOL = 23 | gesetzt
UART3 | Optical Flow | noch nicht festgelegt | geplant
UART4 | Raspberry Pi | SERIAL4_PROTOCOL = 2, SERIAL4_BAUD = 921 | geplant
UART6 | – | SERIAL6_PROTOCOL = -1 | aus

Eine spätere Idee: Der Pi baut eine Karte, in der er Kamera-Erkennungen mit Lidar-Abständen verknüpft. Das kommt erst, wenn SLAM läuft.

## Offene Punkte und nächste Schritte

Als Nächstes kommt die echte Verbindung Pi ↔ FC. Alles andere baut darauf auf.

- ☐ Pi mit UART4 des F405 verkabeln, SERIAL4_PROTOCOL = 2 und SERIAL4_BAUD = 921 setzen
- ☐ config.py auf SIM = False, test_quadrat.py am echten FC mit Propellern ab testen (Heartbeat, Modus, Armen)
- ☐ Ampere-Angabe vom UBEC-Etikett ablesen, dann PSU_MAX_CURRENT im EEPROM des 8-GB-Pi setzen. Ohne den Wert begrenzt der Pi die USB-Ports auf 600 mA, das kann für das Lidar knapp werden.
- ☐ Ausgabe der hailo-apps-Befehle schicken, dann vision.py schreiben (suche_marker(), stop())
- ☐ Optical Flow Matek 3901-L0X an UART3 des FC anschließen und konfigurieren
- ☐ Lidar am Copter montieren und OFFSET einstellen
- ☐ SD-Karte zurück in den 8-GB-Pi, dort free -h, hailortcli fw-control identify, rpicam-hello --list-cameras, vcgencmd get_throttled prüfen
- ☐ ROS2 in Docker mit slam_toolbox und Nav2 auf dem 8-GB-Pi
- ☐ main.py mit der Missionslogik (Zustandsmaschine)

Ein Ersatz für den 8-GB-Pi kostet ca. 80–90 €, falls du ihn wieder normal über USB-C versorgen willst.
